zhaorui4142/HengLiShiHua/Cache_36d1c664d17aa75b.jpg

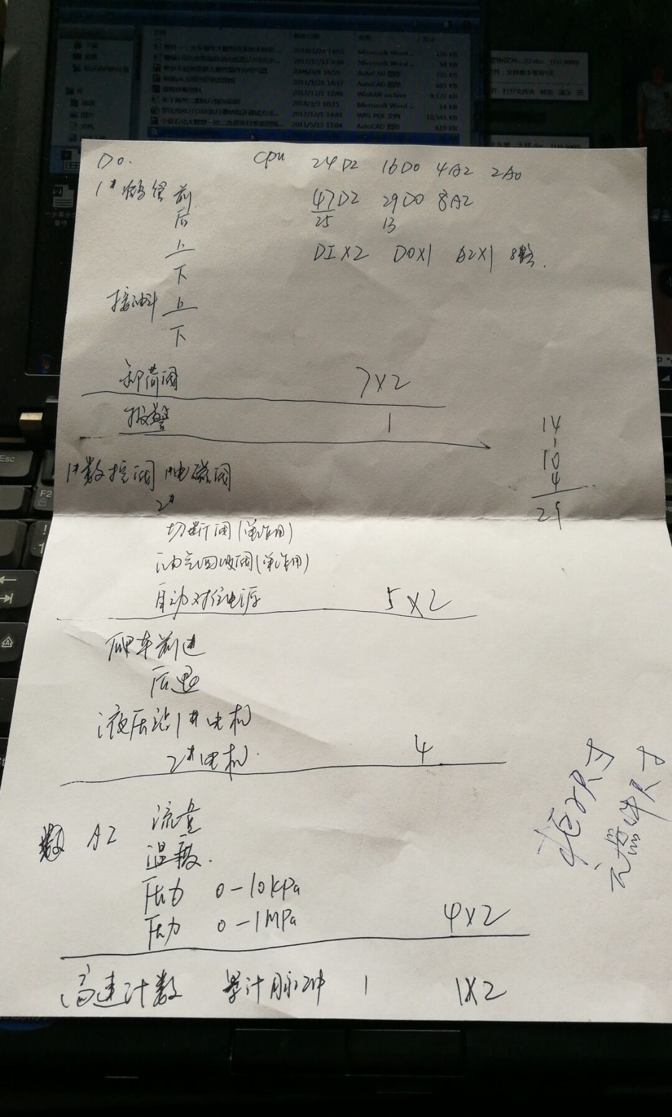
Cache_36d1c664d17aa75b.jpg
