zhaorui4142/HengLiShiHua/Cache_31db7debab5993b0.jpg

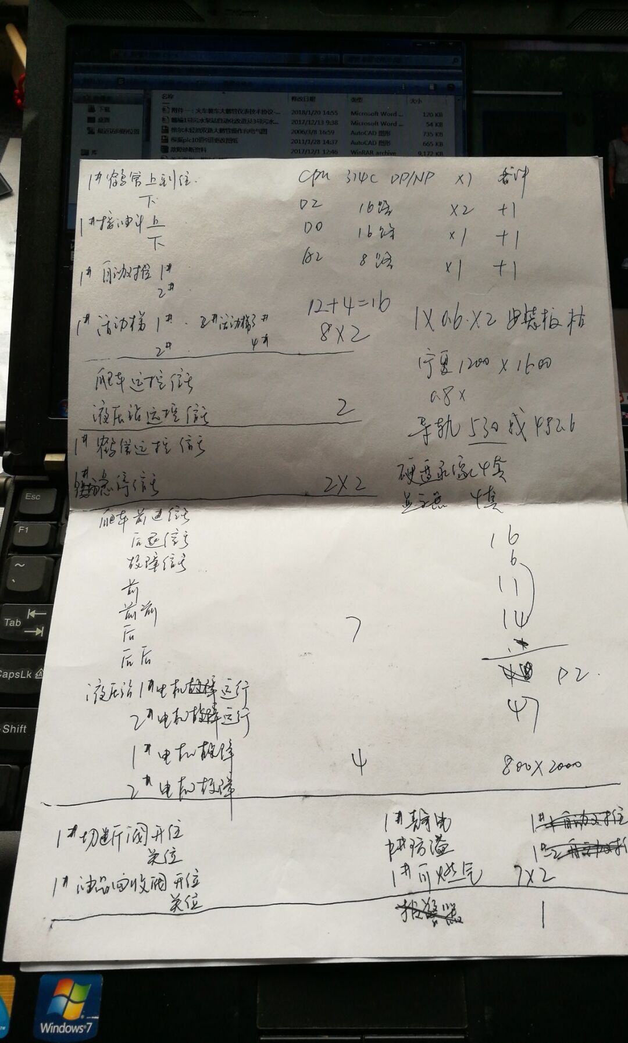
Cache_31db7debab5993b0.jpg
