zhaorui4142/HengLiShiHua/20180207/控制柜设备清单(作废).xlsx

Sheet: 设备列表
 | 以下为2套PLC控制柜的配置清单（现场仪表不包含在这个表格里）
序号 | 设备 | 名称 | 部件编号 | 数量 | 品牌 | 备注
1 | S7-300 | 负载电源，PS 307；AC 120/230V，DC 24V，5A | 6ES7307-1EA01-0AA0 | 2 | 西门子
2 |  | CPU 314C-2 PN/DP (24DI, 16DO, 4AI, 2AO, 1 PT100) | 6ES7314-6EH04-0AB0 | 2 | 西门子
3 |  | 数字量输入 32DI，24V DC；电位隔离 | 6ES7321-1BL00-0AA0 | 4 | 西门子
4 |  | 数字量输出 32DO，24V DC，0.5A；电位隔离 | 6ES7322-1BL00-0AA0 | 2 | 西门子
5 |  | 模拟量输入 8AI；13 位；66ms；电位隔离 | 6ES7331-1KF02-0AB0 | 4 | 西门子
6 |  | 导轨，480 mm | 6ES7390-1AE80-0AA0 | 2 | 西门子
7 |  | 前连接器，40 针，带螺钉触点 | 6ES7392-1AM00-0AA0 | 8 | 西门子
8 |  | 前置连接器，40 针，带弹簧型端子 | 6ES7392-1BM01-0AA0 | 4 | 西门子
9 |  | 微型存储卡，64 KB | 6ES7953-8LF31-0AA0 | 2 | 西门子
10 | 24V电源 | SITOP PSU100L，单相，24 V DC/20 A | 6EP1336-1LB00 | 2 | 西门子
11 | 面板电脑 | PanelIpc577C 19寸 | 6AV7885-0AA10-0AA1 | 2 | 西门子
12 | 嵌入式显示器 | 19寸 |  | 4 | dell | 视频监控用
13 | 硬盘录像机 | HD-DVR-10084路输入，含2T硬盘 |  | 4
14 | 安全栅 | KFD2-SR2-EX2.W |  | 22 | 倍加福 | 每套11个
15 | 空开 | C16A-2P |  | 4
16 | 继电器 | MY2N-J(继电器)+PYF08A-E（底座） |  | 80 | 欧姆龙 | 每套38个+每套2个备用
17 | 接线端子 | UK5N |  | 700 | 菲尼克斯
18 | 接线端子 | UK5-HESI |  | 200 | 菲尼克斯
19 | 接线端子 | USLKG2.5 |  | 50 | 菲尼克斯
20 | 光电收发器（单模） | IMC-21-S-SC |  | 3 | MOXA | 2套安装于操作台，1套安装于远程操作站
21 | 交换机（8口） | SPIDER II 8TX EEC (http://www.hesimann.com/products/806.html) |  | 3 | 赫斯曼/思科 | 2套安装于操作台，1套安装于远程操作站
22 | 双路串口模块 | NPort5232I |  | 2 | MOXA | 安装于操作台，用于流量计通讯转换
23 | RS485光电转换器 | TCF-142-S-SC |  | 3 | MOXA | 2套安装于操作台，1套安装于DCS控制室
24 | 隔爆PLC控制柜 | 隔爆箱体、配套防护柜均为不锈钢304材质 |  | 2
25 | 正压操作台 | 不锈钢304材质 |  | 2
 | 防爆接线箱 | 内部30个接线端子，下端10个G3/4接口，左右各2个G1.5“接口 |  | 4 |  | 装在行走小车上
 | 备品备件 | PLC模块，每种类型各1个 |  | 1

Sheet: IO统计
4套大鹤管，2套一控二控制系统，以下为单套一控二的IO统计
设备 | 数量 | DI | DO | AI | AO | HSC | 安全栅 | 说明
电液阀 | 3个 |  | 6
切断阀 | 5个 | 10 | 5
油气回收阀 | 2个 | 4 | 2
流量计 | 2个 |  |  |  |  | 3
静电 | 2个 | 2
防溢 | 2个 | 2
温变 | 2个 |  |  | 3
压变 | 4个 |  |  | 6
燃气报警器 | 2个 |  |  | 2
声光报警器 | 1个 |  | 1
自动对位 | 2套 |  | 2 | 5 |  |  |  | 1路开关控制，2路信号反馈
密封帽压紧 | 2套 | 2 | 2
小爬车限位 | 4个 | 4 |  |  |  |  | 4
小爬车配电箱 | 1套 | 4 | 2 |  |  |  |  | 反馈：前进/后退/故障/手动 控制：前进/后退
鹤管手动 |  | 2 |  |  |  |  |  | PLC柜面板上的手动/PLC控制切换旋钮
液压站电磁阀 | 2套 |  | 17 |  |  |  |  | 每套鹤管6个动作+1个共用卸荷阀
液压站配电箱 | 1套 | 5 | 2 |  |  |  |  | 反馈：1#电机运行/故障/2#电机运行/故障/手动（12#共用） 控制：1#电机运行/2#电机运行
鹤管限位 | 2套 | 10 |  |  |  |  | 10 | 垂管2个，接油斗2个，水平归位1个（防止2台鹤管相撞）
活动梯限位 | 4个 | 4 |  |  |  |  | 4
总计
