zhaorui4142/HengLiShiHua/资料交付/主要仪表清单.xls

序号 | 名称 | 规格型号 | 单位 | 数量
1 | 防静电控制器 | ET-SGC | 套 | 4
2 | 防溢油控制器 | ET-BLC防爆式音叉开关 | 套 | 4
3 | 自动对位装置 | DW-PX-DC24S | 套 | 4
4 | 本安限位开关 | NJ20+U1+N配置P+F安全栅 | 套 | 8
5 | 本安接近开关 | NJ20+U1+N配置P+F安全栅 | 套 | 24
6 | 活塞式数控阀 |  | 台 | 4
7 | 一体化温度变送器 | 0-100 ℃ | 套 | 4
8 | 全不锈钢压力表 | 0-1.6MPa | 块 | 4
9 | 双金属温度计 | 0-100 ℃ | 支 | 4
10 | 压力变送器 | 0-10KPa ，0-1MPa | 台 | 8
11 | 可燃气体检测器 |  | 套 | 4
12 | 防爆声光报警器 | LED，外壳材质304SS | 套 | 2
