zhaorui4142/HengLiShiHua/资料交付/主要设备清单.xls

序号 | 名称 | 规格型号 | 单位 | 数量
一 | 控制系统
1 | 隔爆PLC控制柜 | 隔爆箱体304材质 | 套 | 2
2 | PLC控制器 | S7-CPU314-DP/PN | 套 | 2
3 | 各种卡件 | SM331/332系列 | 套 | 2
4 | 电气部件 | 空开、继电器、端子等 | 套 | 2
5 | 正压操作台 | 不锈钢304材质 | 套 | 2
6 | 工业平板电脑 | IPC577 19”TFT | 套 | 2
7 | 光电收发器（单模） | MOXA系列 | 套 | 3
8 | 交换机（8口） | 赫斯曼/思科 | 台 | 3
9 | 双路串口模块 | MOXA系列 | 台 | 2
10 | RS485光电转换器 | MOXA系列 | 台 | 3
11 | 装车控制系统软件 | TB-DLCS（含软件、硬件授权） | 套 | 3
12 | 视频设备 |  | 套 | 1
13 | 防爆一体化摄像机 | CAZC250P包含：日夜型摄像机、防爆防护罩、摄像机镜头、支架等 | 套 | 10
14 | 硬盘录像机 | HD-DVR-1008 4路输入，含2T硬盘 | 套 | 4
15 | 嵌入式显示器 | 19〞,DELL | 套 | 4
二 | 大鹤管系统设备
1 | 防静电控制器 | ET-SGC | 套 | 4
2 | 防溢油控制器 | ET-BLC防爆式音叉开关 | 套 | 4
3 | 自动对位装置 | DW-PX-DC24S | 套 | 4
4 | 激光传感器 | DW-PX-LJ02 | 套 | 4
5 | 解码器 | DW-PX-ED02 | 套 | 4
6 | 安装附件 |  | 套 | 4
7 | 本安限位开关 | NJ20+U1+N配置P+F安全栅 | 套 | 8
8 | 本安接近开关 | NJ20+U1+N配置P+F安全栅 | 套 | 24
三 | 现场仪表设备
1 | 活塞式数控阀 |  | 台 | 4
2 | 一体化温度变送器 | 0-100 ℃ | 套 | 4
3 | 全不锈钢压力表 | 0-1.6MPa | 块 | 4
4 | 双金属温度计 | 0-100 ℃ | 支 | 4
5 | 压力变送器 | 0-10KPa ，0-1MPa | 台 | 8
6 | 可燃气体检测器 |  | 套 | 4
7 | 防爆声光报警器 | LED，外壳材质304SS | 套 | 2
8 | 增安接线箱 | EXeIICT4，材质304SS | 批 | 1
9 | 仪表安装材料 | 电缆、接线箱等 | 批 | 1
