zhaorui4142/HengLiShiHua/20180207/电缆线列表.xlsx

电缆线列表
一 控制电缆
 | 电缆 |  |  | 起点 |  |  | 终点 |  |  | 备注 | 估算长度
序号 | 电缆编号 | 电缆型号 | 电缆规格 | 起点位置 | 位号 | 接口 | 终点 | 位号 | 接口
1 |  | ZC-KVVPR | 3*1.5 | 1#鹤管气动切断阀 | 1FV1 |  | 防爆PLC控制柜 | PSD1 | G3/4 | 电磁阀 | 30
2 |  | ZC-KVVPR | 3*1.5 | 1#鹤管气动切断阀 | 1FV1 |  | 防爆PLC控制柜 | PSD1 | G3/4 | 开关回讯 | 30
3 |  | ZC-KVVPR | 3*1.5 | 1#鹤管气动切断阀 | 1FV1 |  | 防爆PLC控制柜 | PSD1 | G3/4 | 电磁阀 | 30
4 |  | ZC-KVVPR | 3*1.5 | 1#鹤管气动切断阀 | 1FV1 |  | 防爆PLC控制柜 | PSD1 | G3/4 | 开关回讯 | 30
5 |  | ZC-KVVPR | 3*1.5 | 1#鹤管气动切断阀 | 1FV1 |  | 防爆PLC控制柜 | PSD1 | G3/4 | 电磁阀 | 30
6 |  | ZC-KVVPR | 3*1.5 | 1#鹤管气动切断阀 | 1FV1 |  | 防爆PLC控制柜 | PSD1 | G3/4 | 开关回讯 | 30
7 |  | ZC-KVVPR | 4*1.5 | 1#鹤管液相管道压力变送器 | 1PT1 |  | 防爆PLC控制柜 | PSD1 | G3/4 | 4-20mA | 30
8 |  | ZC-KVVPR | 4*1.5 | 1#鹤管液相管道温度变送器 | 1TT1 |  | 防爆PLC控制柜 | PSD1 | G3/4 | 4-20mA | 30
9 |  | ZC-KVVPR | 4*1.5 | 1#鹤管气相管道压力变送器 | 1PT2 |  | 防爆PLC控制柜 | PSD1 | G3/4 | 4-20mA | 30
10 |  | ZC-KVVPR | 4*1.5 | 1#鹤管液相管道压力变送器 | 1PT1 |  | 防爆PLC控制柜 | PSD1 | G3/4 | 4-20mA | 30
11 |  | ZC-KVVPR | 4*1.5 | 1#鹤管液相管道温度变送器 | 1TT1 |  | 防爆PLC控制柜 | PSD1 | G3/4 | 4-20mA | 30
12 |  | ZC-KVVPR | 4*1.5 | 1#鹤管气相管道压力变送器 | 1PT2 |  | 防爆PLC控制柜 | PSD1 | G3/4 | 4-20mA | 30
13 |  | ZC-KVVPR | 3*1.5 | 1#鹤管油气回收阀 | 1FV2 |  | 防爆PLC控制柜 | PSD1 | G3/4 | 电磁阀 | 30
14 |  | ZC-KVVPR | 3*1.5 | 1#鹤管油气回收阀 | 1FV2 |  | 防爆PLC控制柜 | PSD1 | G3/4 | 开关回讯 | 30
15 |  | ZC-KVVPR | 3*1.5 | 1#鹤管质量流量计 | 1MFT |  | 防爆PLC控制柜 | PSD1 | G3/4 | 电源 | 30
16 |  | ZC-KVVPR | 3*1.5 | 1#鹤管质量流量计 | 1MFT |  | 防爆PLC控制柜 | PSD1 | G3/4 | 脉冲输出 | 30
17 |  | ZC-RVSP | 2*1.5 | 1#鹤管质量流量计 | 1MFT |  | 正压防爆操作柜 | PCZ1 | G3/4 | 485通信 | 30
18 |  | ZC-KVVPR | 3*1.5 | 1#鹤管质量流量计 | 1MFT |  | 防爆PLC控制柜 | PSD1 | G3/4 | 电源 | 30
19 |  | ZC-KVVPR | 3*1.5 | 1#鹤管质量流量计 | 1MFT |  | 防爆PLC控制柜 | PSD1 | G3/4 | 脉冲输出 | 30
20 |  | ZC-RVSP | 2*1.5 | 1#鹤管质量流量计 | 1MFT |  | 正压防爆操作柜 | PCZ1 | G3/4 | 485通信 | 30
21
22 |  | ZC-KVVPR | 4*1.5 | 1#鹤管电液阀 | 1FV3 |  | 防爆PLC控制柜 | PSD1 | G3/4 | 电磁阀*2 | 30
23 |  | ZC-KVVPR | 4*1.5 | 1#鹤管电液阀 | 1FV3 |  | 防爆PLC控制柜 | PSD1 | G3/4 | 电磁阀*2 | 30
24 |  | ZC-KVVPR | 3*1.5 | 1#鹤管静电控制器 | 1ESA | G3/4 | 防爆PLC控制柜 | PSD1 | G3/4 | 电源+信号 | 30
25 |  | ZC-KVVPR | 3*1.5 | 1#鹤管防溢控制器 | 1LSA | G3/4 | 防爆PLC控制柜 | PSD1 | G3/4 | 电源+信号 | 30
26 |  | 防溢探头配套电缆 |  | 1#鹤管防溢控制器 | 1LSA | 传感器配套 | 大鹤管密封帽 | 1WHS | 传感器配套 | 防溢控制器自带电缆 | 12
27 |  | ZC-KVVPR | 12*1.0 | 1#鹤管接线箱（鹤管行走小车上） | 1JXC1 | G1-1/2 | 防爆PLC控制柜 | PSD1 | G1-1/2 | 多路开关量信号 | 30
28 |  | ZC-KVVPR | 12*1.0 | 1#鹤管接线箱（鹤管行走小车上） | 1JXC1 | G1-1/2 | 防爆PLC控制柜 | PSD1 | G1-1/2 | 多路开关量信号 | 30
29 |  | ZC-KVVPR | 3*1.5 | 1#鹤管接线箱（鹤管行走小车上） | 1JXC1 | G3/4 | 接近开关-鹤管上限位 | 1SL1 | M20*1.5 | 接近开关供电+信号 | 5
30 |  | ZC-KVVPR | 3*1.5 | 1#鹤管接线箱（鹤管行走小车上） | 1JXC1 | G3/4 | 接近开关-鹤管下限位 | 1SL2 | M20*1.5 | 接近开关供电+信号 | 5
31 |  | ZC-KVVPR | 3*1.5 | 1#鹤管接线箱（鹤管行走小车上） | 1JXC1 | G3/4 | 接近开关-接油斗上限位 | 1SL3 | M20*1.5 | 接近开关供电+信号 | 5
32 |  | ZC-KVVPR | 3*1.5 | 1#鹤管接线箱（鹤管行走小车上） | 1JXC1 | G3/4 | 接近开关-接油斗下限位 | 1SL4 | M20*1.5 | 接近开关供电+信号 | 5
33 |  | ZC-KVVPR | 3*1.5 | 1#鹤管接线箱（鹤管行走小车上） | 1JXC1 | G3/4 | 接近开关-鹤管水平归位 | 1SL5 | M20*1.5 | 接近开关供电+信号 | 5
34 |  | ZC-KVVPR | 3*1.5 | 1#鹤管接线箱（鹤管行走小车上） | 1JXC1 | G3/4 | 接近开关-鹤管水平归位 | 1SL5 | M20*1.5 | 接近开关供电+信号 | 5
35 |  | ZC-KVVPR | 4*1.5 | 1#鹤管接线箱（鹤管行走小车上） | 1JXC1 | G3/4 | 传感器-自动对位探头1 | 1DW1 |  | 自动对位供电+信号 | 7
36 |  | ZC-KVVPR | 4*1.5 | 1#鹤管接线箱（鹤管行走小车上） | 1JXC1 | G3/4 | 传感器-自动对位探头2 | 1DW2 |  | 自动对位供电+信号 | 7
37 |  | ZC-KVVPR | 3*1.5 | 2#鹤管气动切断阀 | 2FV1 |  | 防爆PLC控制柜 | PSD1 | G3/4 | 电磁阀 | 30
38 |  | ZC-KVVPR | 3*1.5 | 2#鹤管气动切断阀 | 2FV1 |  | 防爆PLC控制柜 | PSD1 | G3/4 | 开关回讯 | 30
39 |  | ZC-KVVPR | 4*1.5 | 2#鹤管液相管道压力变送器 | 2PT1 |  | 防爆PLC控制柜 | PSD1 | G3/4 | 4-20mA | 30
40 |  | ZC-KVVPR | 4*1.5 | 2#鹤管液相管道温度变送器 | 2TT1 |  | 防爆PLC控制柜 | PSD1 | G3/4 | 4-20mA | 30
41 |  | ZC-KVVPR | 3*1.5 | 2#鹤管油气回收阀 | 2FV2 |  | 防爆PLC控制柜 | PSD1 | G3/4 | 电磁阀 | 30
42 |  | ZC-KVVPR | 3*1.5 | 2#鹤管油气回收阀 | 2FV2 |  | 防爆PLC控制柜 | PSD1 | G3/4 | 开关回讯 | 30
43 |  | ZC-KVVPR | 3*1.5 | 2#鹤管质量流量计 | 2MFT |  | 防爆PLC控制柜 | PSD1 | G3/4 | 电源 | 30
44 |  | ZC-KVVPR | 3*1.5 | 2#鹤管质量流量计 | 2MFT |  | 防爆PLC控制柜 | PSD1 | G3/4 | 脉冲输出 | 30
45 |  | ZC-RVSP | 2*1.5 | 2#鹤管质量流量计 | 2MFT |  | 正压防爆操作柜 | PCZ1 | G3/4 | 485通信 | 30
46 |  | ZC-KVVPR | 4*1.5 | 2#鹤管气相管道压力变送器 | 2PT2 |  | 防爆PLC控制柜 | PSD1 | G3/4 | 4-20mA | 30
47 |  | ZC-KVVPR | 4*1.5 | 2#鹤管电液阀 | 2FV3 |  | 防爆PLC控制柜 | PSD1 | G3/4 | 电磁阀*2 | 30
48 |  | ZC-KVVPR | 3*1.5 | 2#鹤管静电控制器 | 2ESA | G3/4 | 防爆PLC控制柜 | PSD1 | G3/4 | 电源+信号 | 30
49 |  | ZC-KVVPR | 3*1.5 | 2#鹤管防溢控制器 | 2LSA | G3/4 | 防爆PLC控制柜 | PSD1 | G3/4 | 电源+信号 | 30
50 |  | 防溢探头配套电缆 |  | 2#鹤管防溢控制器 | 2LSA | 传感器配套 | 大鹤管密封帽 | 2WHS | 传感器配套 | 防溢控制器自带电缆 | 12
51 |  | ZC-KVVPR | 12*1.0 | 2#鹤管接线箱（鹤管行走小车上） | 2JXC1 | G1-1/2 | 防爆PLC控制柜 | PSD1 | G1-1/2 | 多路开关量信号 | 30
52 |  | ZC-KVVPR | 12*1.0 | 2#鹤管接线箱（鹤管行走小车上） | 2JXC1 | G1-1/2 | 防爆PLC控制柜 | PSD1 | G1-1/2 | 多路开关量信号 | 30
53 |  | ZC-KVVPR | 3*1.5 | 2#鹤管接线箱（鹤管行走小车上） | 2JXC1 | G3/4 | 接近开关-鹤管上限位 | 2SL1 | M20*1.5 | 接近开关供电+信号 | 5
54 |  | ZC-KVVPR | 3*1.5 | 2#鹤管接线箱（鹤管行走小车上） | 2JXC1 | G3/4 | 接近开关-鹤管下限位 | 2SL2 | M20*1.5 | 接近开关供电+信号 | 5
55 |  | ZC-KVVPR | 3*1.5 | 2#鹤管接线箱（鹤管行走小车上） | 2JXC1 | G3/4 | 接近开关-接油斗上限位 | 2SL3 | M20*1.5 | 接近开关供电+信号 | 5
56 |  | ZC-KVVPR | 3*1.5 | 2#鹤管接线箱（鹤管行走小车上） | 2JXC1 | G3/4 | 接近开关-接油斗下限位 | 2SL4 | M20*1.5 | 接近开关供电+信号 | 5
57 |  | ZC-KVVPR | 3*1.5 | 2#鹤管接线箱（鹤管行走小车上） | 2JXC1 | G3/4 | 接近开关-鹤管水平归位 | 2SL5 | M20*1.5 | 接近开关供电+信号 | 5
58 |  | ZC-KVVPR | 3*1.5 | 2#鹤管接线箱（鹤管行走小车上） | 2JXC1 | G3/4 | 接近开关-鹤管水平归位 | 2SL5 | M20*1.5 | 接近开关供电+信号
59 |  | ZC-KVVPR | 4*1.5 | 2#鹤管接线箱（鹤管行走小车上） | 2JXC1 | G3/4 | 传感器-自动对位探头1 | 2DW1 | G3/4（暂定） | 自动对位供电+信号 | 7
60 |  | ZC-KVVPR | 4*1.5 | 2#鹤管接线箱（鹤管行走小车上） | 2JXC1 | G3/4 | 传感器-自动对位探头2 | 2DW2 | G3/4（暂定） | 自动对位供电+信号 | 7
61 |  | ZC-KVVPR | 4*1.5 | 1#2#鹤管共用爬车对位探头 | PCDW1 | G3/4 | 防爆PLC控制柜 | PSD1 | G3/4 | 自动对位供电+信号 | 30
62 |  | ZC-KVVPR | 4*1.5 | 1#2#鹤管共用可燃气体报警器1 | GAS1 |  | 防爆PLC控制柜 | PSD1 | G3/4 | 4-20mA | 30
63 |  | ZC-KVVPR | 4*1.5 | 1#2#鹤管共用可燃气体报警器2 | GAS2 |  | 防爆PLC控制柜 | PSD1 | G3/4 | 4-20mA | 30
64 |  | ZC-KVVPR | 3*1.5 | 1#2#鹤管共用声光报警器 | AL1 |  | 防爆PLC控制柜 | PSD1 | G3/4 | 供电DC24V | 30
65 |  | ZC-KVVPR | 3*1.5 | 活动梯1接近开关 | SL5 | M20*1.5 | 防爆PLC控制柜 | PSD1 | G3/4 | 接近开关供电+信号 | 10
66 |  | ZC-KVVPR | 3*1.5 | 活动梯2接近开关 | SL6 | M20*1.5 | 防爆PLC控制柜 | PSD1 | G3/4 | 接近开关供电+信号 | 15
67 |  | ZC-KVVPR | 3*1.5 | 活动梯3接近开关 | SL7 | M20*1.5 | 防爆PLC控制柜 | PSD1 | G3/4 | 接近开关供电+信号 | 20
68 |  | ZC-KVVPR | 3*1.5 | 活动梯4接近开关 | SL8 | M20*1.5 | 防爆PLC控制柜 | PSD1 | G3/4 | 接近开关供电+信号 | 25
69 |  | ZC-KVVPR | 3*1.5 | 爬车限位1（前前限位） | SQ1 | M20*1.5 | 防爆PLC控制柜 | PSD1 | G3/4 | 接近开关供电+信号 | 40
70 |  | ZC-KVVPR | 3*1.5 | 爬车限位2（前限位） | SQ2 | M20*1.5 | 防爆PLC控制柜 | PSD1 | G3/4 | 接近开关供电+信号 | 40
71 |  | ZC-KVVPR | 3*1.5 | 爬车限位3（后限位） | SQ3 | M20*1.5 | 防爆PLC控制柜 | PSD1 | G3/4 | 接近开关供电+信号 | 40
72 |  | ZC-KVVPR | 3*1.5 | 爬车限位4（后后限位） | SQ4 | M20*1.5 | 防爆PLC控制柜 | PSD1 | G3/4 | 接近开关供电+信号 | 40
73 |  | ZC-KVVPR | 12*1.0 | 1#2#鹤管共用液压站 | YYZ1 | G1-1/2 | 防爆PLC控制柜 | PSD1 | G1-1/2 | 电磁阀组 | 30
74 |  | ZC-KVVPR | 12*1.0 | 1#2#鹤管共用液压站 | YYZ1 | G1-1/2 | 防爆PLC控制柜 | PSD1 | G1-1/2 | 电磁阀组 | 30
75 |  | ZC-KVVPR | 10*1.0 | 液压站+爬车电机配电柜 | QYC1 | G1-1/2 | 防爆PLC控制柜 | PSD1 | G1-1/2 | 控制信号 | 10
76 |  | ZC-KVVPR | 10*1.0 | 液压站+爬车电机配电柜 | QYC1 | G1-1/2 | 防爆PLC控制柜 | PSD1 | G1-1/2 | 反馈信号 | 10
77 |  | ZC-KVVPR | 3*1.5 | 正压防爆操作柜 | PCZ1 | G3/4 | 防爆PLC控制柜 | PSD1 | G3/4 | 急停按钮信号 | 10
78 |  | ZC-KVVPR | 3*1.5 | 正压防爆操作柜 | PCZ1 | G3/4 | 防爆PLC控制柜 | PSD1 | G3/4 | 急停按钮信号 | 10
79 |  | 网线 | cat5e | 正压防爆操作柜 | PCZ1 | G3/4 | 防爆PLC控制柜 | PSD1 | G3/4 | PLC通信 | 10
80 |  | 光缆 | 单模 | 正压防爆操作柜 | PCZ1 | G3/4 | DCS控制室 |  |  | 通信
81 |  | 光缆 | 单模 | 正压防爆操作柜 | PCZ1 | G3/4 | 远程操作站 |  |  | 通信
82 |  | DP通信线 |  | 第一个栈桥防爆PLC控制柜 | PSD1 | G3/4 | 第二个栈桥防爆PLC控制柜 | PSD1 | G3/4 | 通信 | 150
二 视频监控电缆
 | 电缆 |  |  | 起点 |  |  | 终点 |  |  | 备注 | 估算长度
序号 | 电缆编号 | 电缆型号 | 电缆规格 | 起点位置 | 位号 | 接口 | 终点 | 位号 | 接口
1 |  | 同轴电缆 | SYV75-5 | 1#鹤管罐口监控摄像机 | 1TV1 | G3/4 | 正压防爆操作柜 | PCZ1 | G3/4 | 视频信号 | 30
2 |  | ZC-KVVPR | 3*1.5 | 1#鹤管罐口监控摄像机 | 1TV1 | G3/4 | 正压防爆操作柜 | PCZ1 | G3/4 | 摄像机供电 | 30
3 |  | 同轴电缆 | SYV75-5 | 2#鹤管罐口监控摄像机 | 2TV1 | G3/4 | 正压防爆操作柜 | PCZ1 | G3/4 | 视频信号 | 30
4 |  | ZC-KVVPR | 3*1.5 | 2#鹤管罐口监控摄像机 | 2TV1 | G3/4 | 正压防爆操作柜 | PCZ1 | G3/4 | 摄像机供电 | 30
5 |  | 同轴电缆 | SYV75-5 | 装车现场监控摄像机 | 1TV2 | G3/4 | 正压防爆操作柜 | PCZ1 | G3/4 | 视频信号 | 30
6 |  | ZC-KVVPR | 3*1.5 | 装车现场监控摄像机 | 1TV2 | G3/4 | 正压防爆操作柜 | PCZ1 | G3/4 | 摄像机供电 | 30
7 |  | 同轴电缆 | SYV75-5 | 爬车监控摄像机 | 1TV3 | G3/4 | 正压防爆操作柜 | PCZ1 | G3/4 | 视频信号 | 30
8 |  | ZC-KVVPR | 3*1.5 | 爬车监控摄像机 | 1TV3 | G3/4 | 正压防爆操作柜 | PCZ1 | G3/4 | 摄像机供电 | 30
9 |  | 同轴电缆 | SYV75-5 | 铁路线监控摄像机 | 1TV4 | G3/4 | 正压防爆操作柜 | PCZ1 | G3/4 | 视频信号 | 30
10 |  | ZC-KVVPR | 3*1.5 | 铁路线监控摄像机 | 1TV4 | G3/4 | 正压防爆操作柜 | PCZ1 | G3/4 | 摄像机供电 | 30
11 |  | ZC-KVVPR | 3*1.5 | 1#鹤管罐口监控云台 | 1YT1 | G3/4 | 正压防爆操作柜 | PCZ1 | G3/4 | 云台供电 | 30
12 |  | ZC-RVSP | 2*1.5 | 1#鹤管罐口监控云台 | 1YT1 | G3/4 | 正压防爆操作柜 | PCZ1 | G3/4 | 云台485控制 | 30
13 |  | ZC-KVVPR | 3*1.5 | 2#鹤管罐口监控云台 | 2YT1 | G3/4 | 正压防爆操作柜 | PCZ1 | G3/4 | 云台供电 | 30
14 |  | ZC-RVSP | 2*1.5 | 2#鹤管罐口监控云台 | 2YT1 | G3/4 | 正压防爆操作柜 | PCZ1 | G3/4 | 云台485控制 | 30
三 电力电缆
 | 电缆 |  |  | 起点 |  |  | 终点 |  |  | 备注 | 估算长度
序号 | 电缆编号 | 电缆型号 | 电缆规格 | 起点位置 | 位号 | 接口 | 终点 | 位号 | 接口
1 |  | ZR-YJV | 3*2.5 | 正压防爆操作柜 | PCZ1 | G1 | 配电房 |  |  | 1kW AC220V
2 |  | ZR-YJV | 3*2.5 | 防爆PLC控制柜 | PSD1 | G1-1/2 | 配电房 |  |  | 1kW AC220V
3 |  | ZR-YJV | 3*35+1*16 | 液压站+爬车电机配电柜 | QYC1 |  | 配电房 |  |  | 45kW三相380V
4 |  | ZR-YJV | 3*25+1*16 | 液压站+爬车电机配电柜 | QYC1 |  | 爬车电机 |  |  | 30kW三相380V | 40
5 |  | ZR-YJV | 3*4.0+1*2.5 | 液压站+爬车电机配电柜 | QYC1 |  | 液压站电机1 |  |  | 7.5kW三相380V | 30
6 |  | ZR-YJV | 3*4.0+1*2.5 | 液压站+爬车电机配电柜 | QYC1 |  | 液压站电机2 |  |  | 7.5kW三相380V | 30
