zhaorui4142/HengLiShiHua/(list of files, cad)

Other CAD files:
20180207/正压防爆柜接线图.dwg
PLC隔爆箱.dwg
新建文件夹/接线图04.dwg
资料交付/大鹤管PID.dwg
20180207/PLC控制箱接线图.dwg
PLC隔爆箱07 - 副本.dwg
新建文件夹/PLC隔爆箱04.dwg
资料交付/大鹤管控制系统系统图.dwg
邮件附件180202/汽油大鹤管P&ID图切断阀位置.dwg
20180207/PLC控制箱外形图.dwg
PLC隔爆箱04.dwg
资料交付/2017.03.27工艺流程图.dwg
邮件附件180202/柴油大鹤管P&ID图切断阀位置.dwg
20180207/PLC控制箱接线图04.dwg
小爬车液压站防爆柜图.dwg
控制系统1PSD.dwg
琴台式正压柜.dwg
控制系统系统图.rev1.dwg
接线图.dwg
邮件附件180202/570141G31000_火车装车PID2017-04-05-yu自控修改1.dwg
