zhaorui4142/HengLiShiHua/PLC隔爆箱.pdf

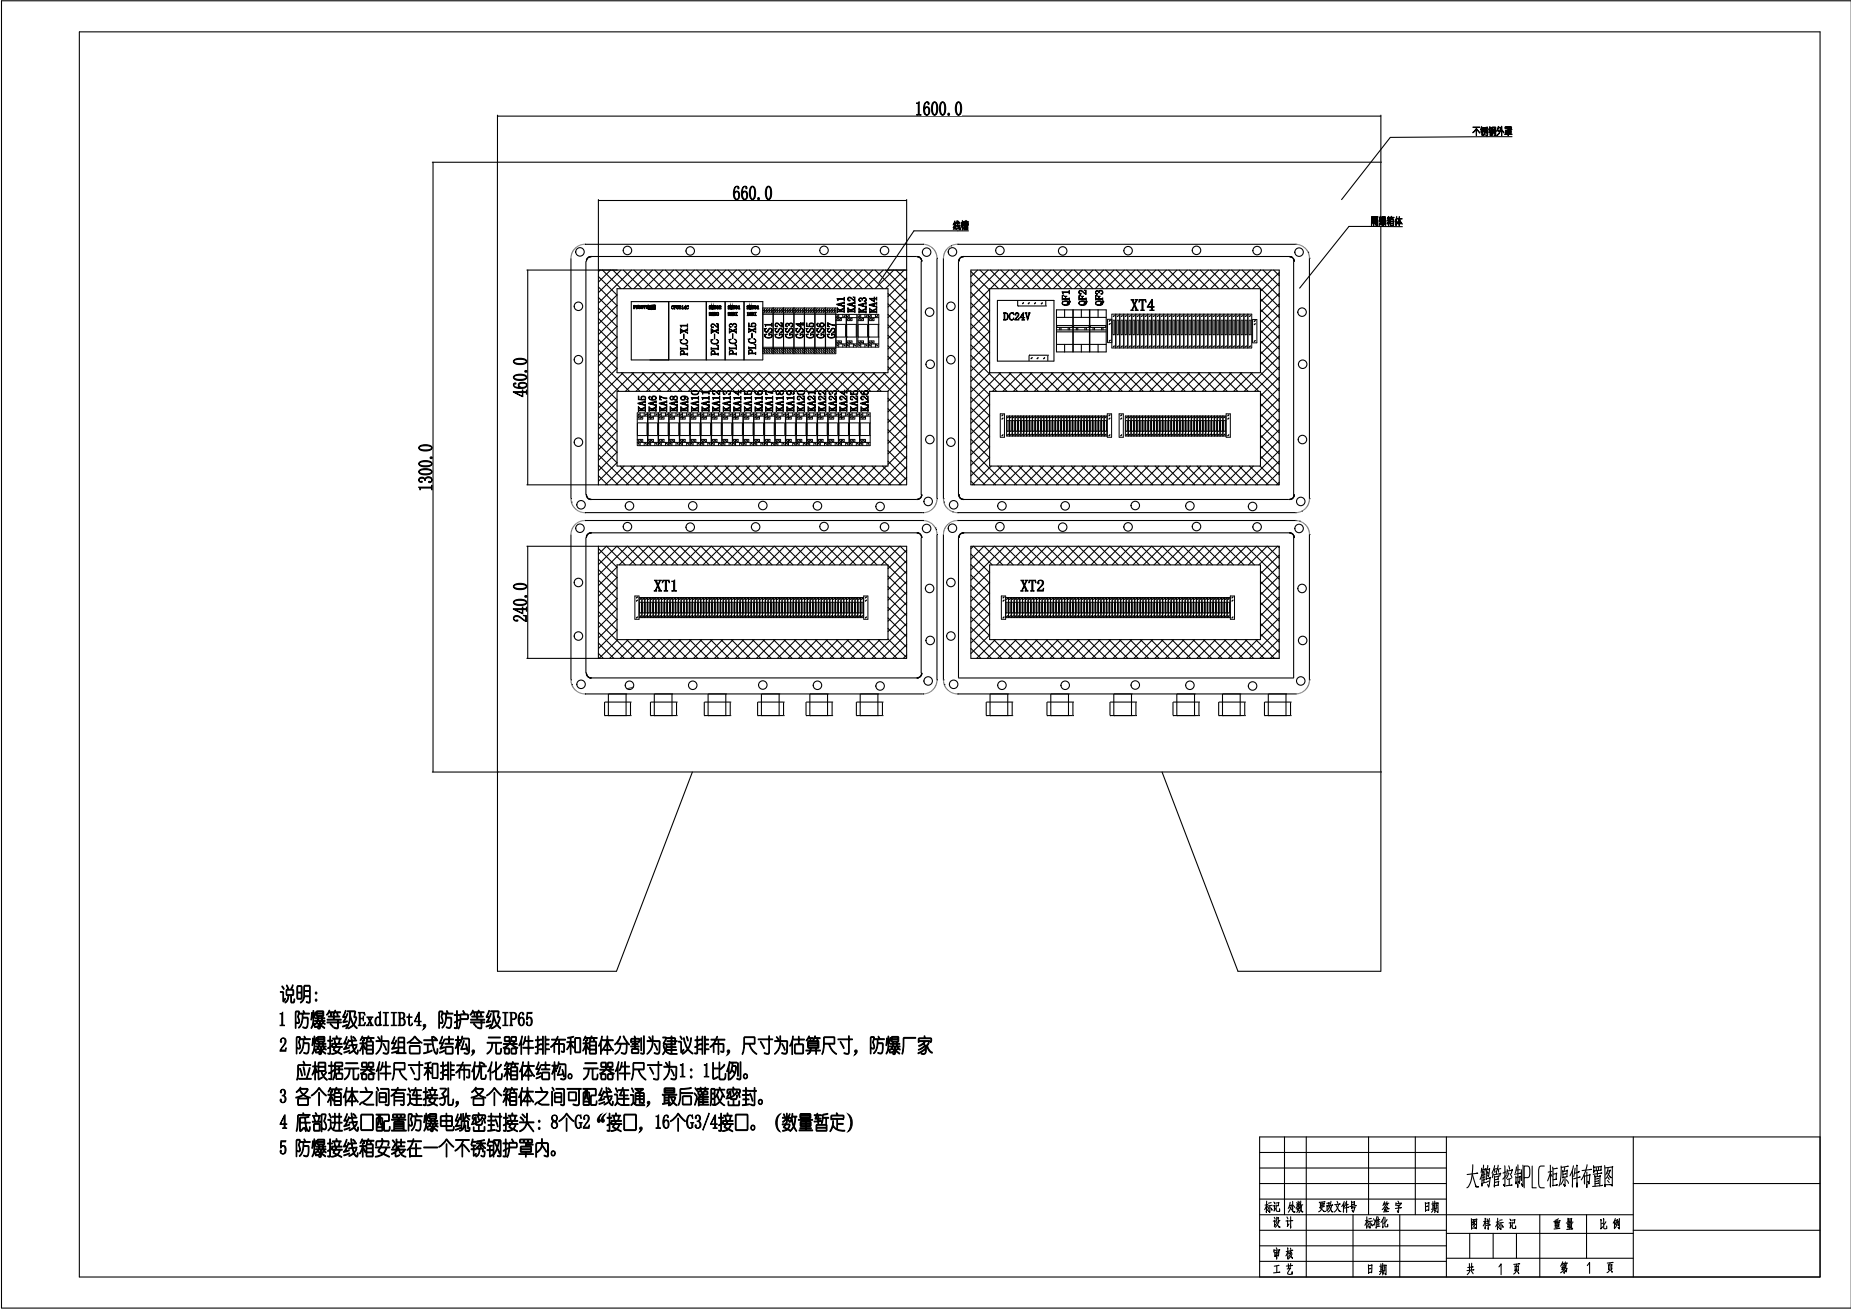
[picture p3: page 1]
