zhaorui4142/HengLiShiHua/琴台式正压柜.pdf

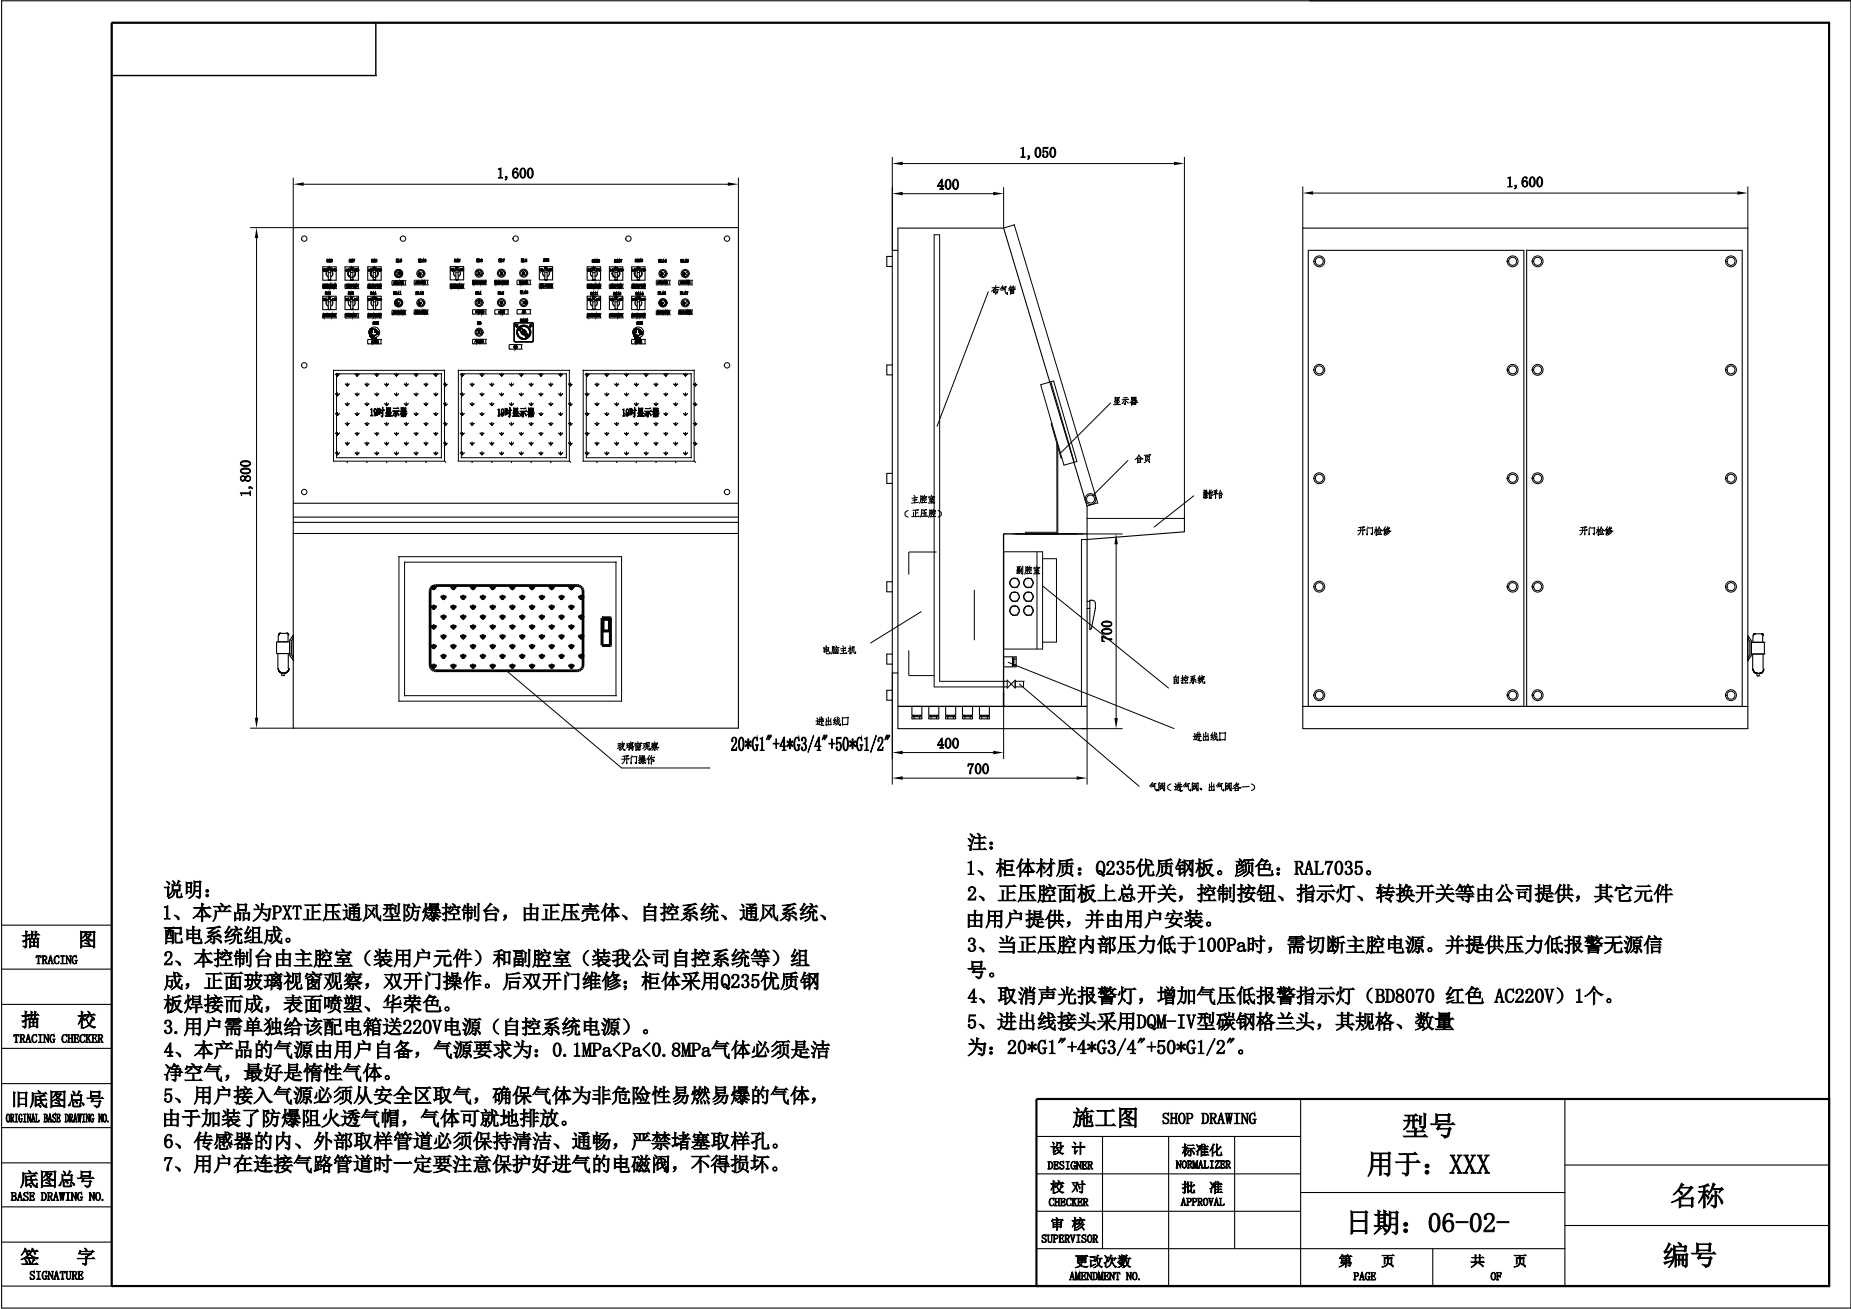
[picture p4: page 1]
