zhaorui4142/HengLiShiHua/(commit log)

2018-04-23 4月23日，加入摄像机资料
2018-04-24 4月24日，开始画正压柜的图，画了一半
2018-04-25 4月25日，继续画正压柜接线图
2018-04-26 4月26日，正压柜的的，发现漏了24V开关电源
    [PLC控制箱接线图.dwg]
2018-04-27 4月27，还有串口网关没有定下来
    [PLC控制箱接线图.dwg]
2018-04-28 在办公室修改，正压防爆柜的图以画完
    [控制柜设备清单(作废).xlsx, 控制柜设备清单(模块型号数量变更).xlsx, 正压防爆柜接线图.dwg]
